freeDSP/freeDSPx-UNBAL-OUT-x8/(commit log)

2016-02-11 + added standard folder structure + commit of old V1.0 (only compatible with SMD freeDSP)
    [PCM1681.kicad_pcb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]
2016-05-17 - fixed mirrored stereo jack
    [PCM1681.kicad_pcb]
2016-06-10 -removed gerber files from trunk
    [PCM1681-B.Cu.gbr, PCM1681-B.Mask.gbr, PCM1681-Edge.Cuts.gbr, PCM1681-F.Cu.gbr, PCM1681-F.Mask.gbr, PCM1681-NPTH.drl, PCM1681.drl]
2016-06-10 - updated labels an generated gerber
    [PCM1681.kicad_pcb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]
2018-02-04 - added a ignore file - removed gerber files - did a cosmetic update where the stereo jacks were mirrored in the footprint as well as on the board. so nothing changed except that the jacks are now co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
    [PCM1681.kicad_pcb, PCM1681.sch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]
2018-03-10 - added a via underneath the DAC for handsolderding - basis commit for V1.1
    [PCM1681.kicad_pcb]
